cyberpank00/PLCJS_ETH_MODULE_12DQ_D4MG_STM32F407VGT6/DOC/SCM_12DQ.pdf

A A

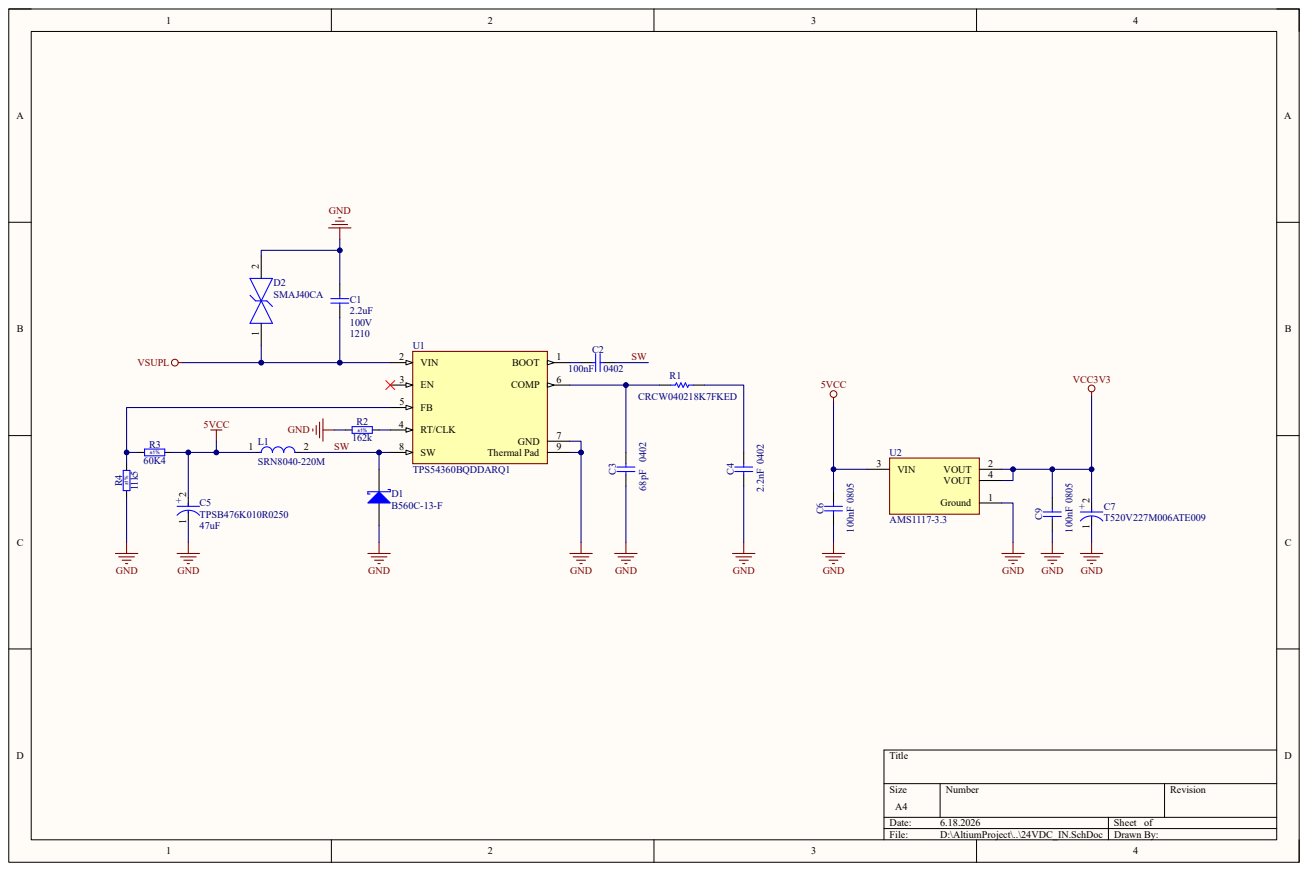
[picture p2: page 1]

11

22

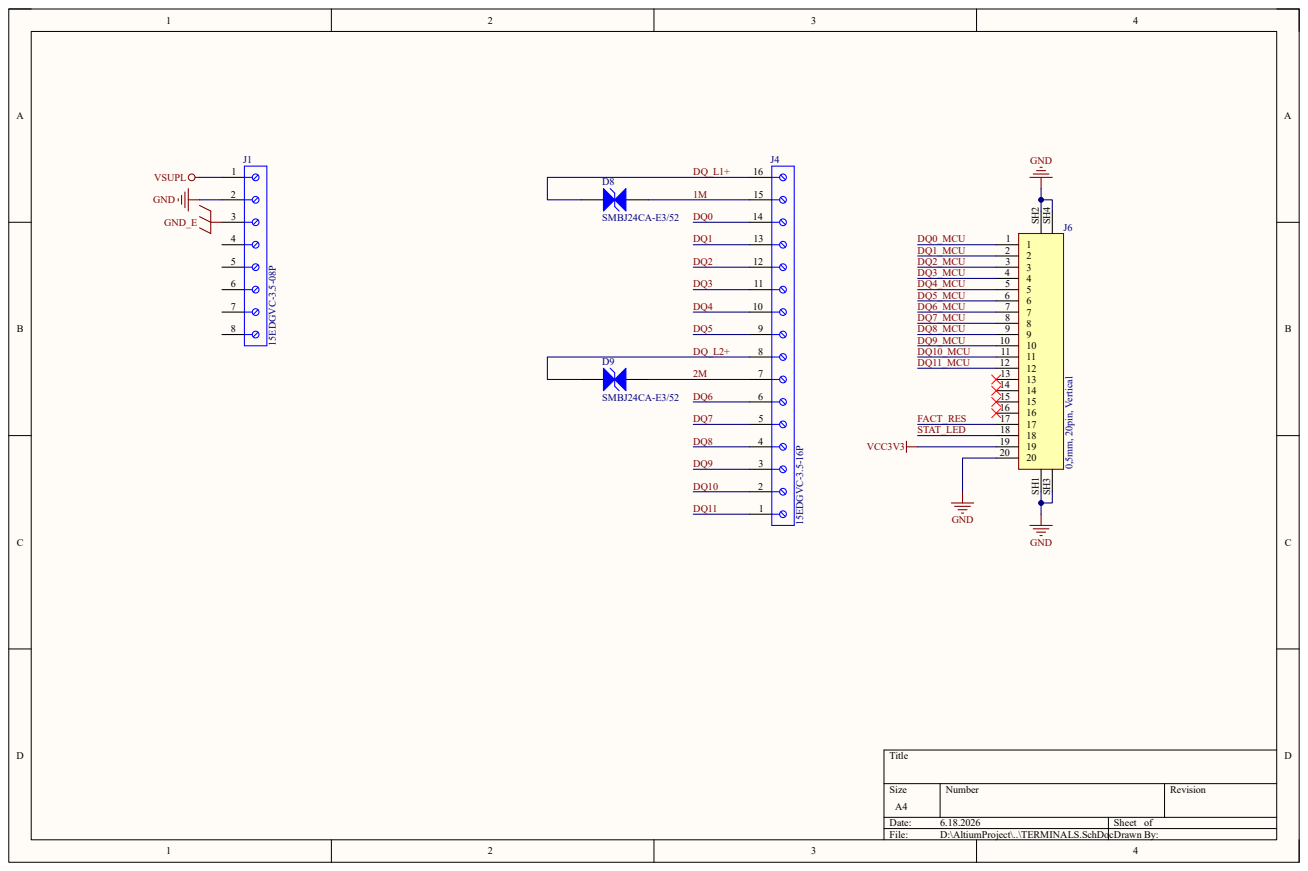
[picture p3: page 2]
Title; Size; Number; Revision; Date:; Sheet of; File:; D:\AltiumProject\..\TERMINALS.SchDocDrawn By:; VSUPL; GND; VCC3V3; 15EDGVC⁻³.5⁻08P; SH¹ SH³ SH² SH⁴; J60,5mm, 20pin, Vertical; 15EDGVC⁻³.5⁻16P; DQ0_MCU DQ1_MCU DQ2_MCU DQ3_MCU DQ4_MCU DQ5_MCU DQ6_MCU DQ7_MCU DQ8_MCU DQ9_MCU DQ10_MCU DQ11_MCU; STAT_LED; FACT_RES; GND_E; SMBJ24CA-E3/52

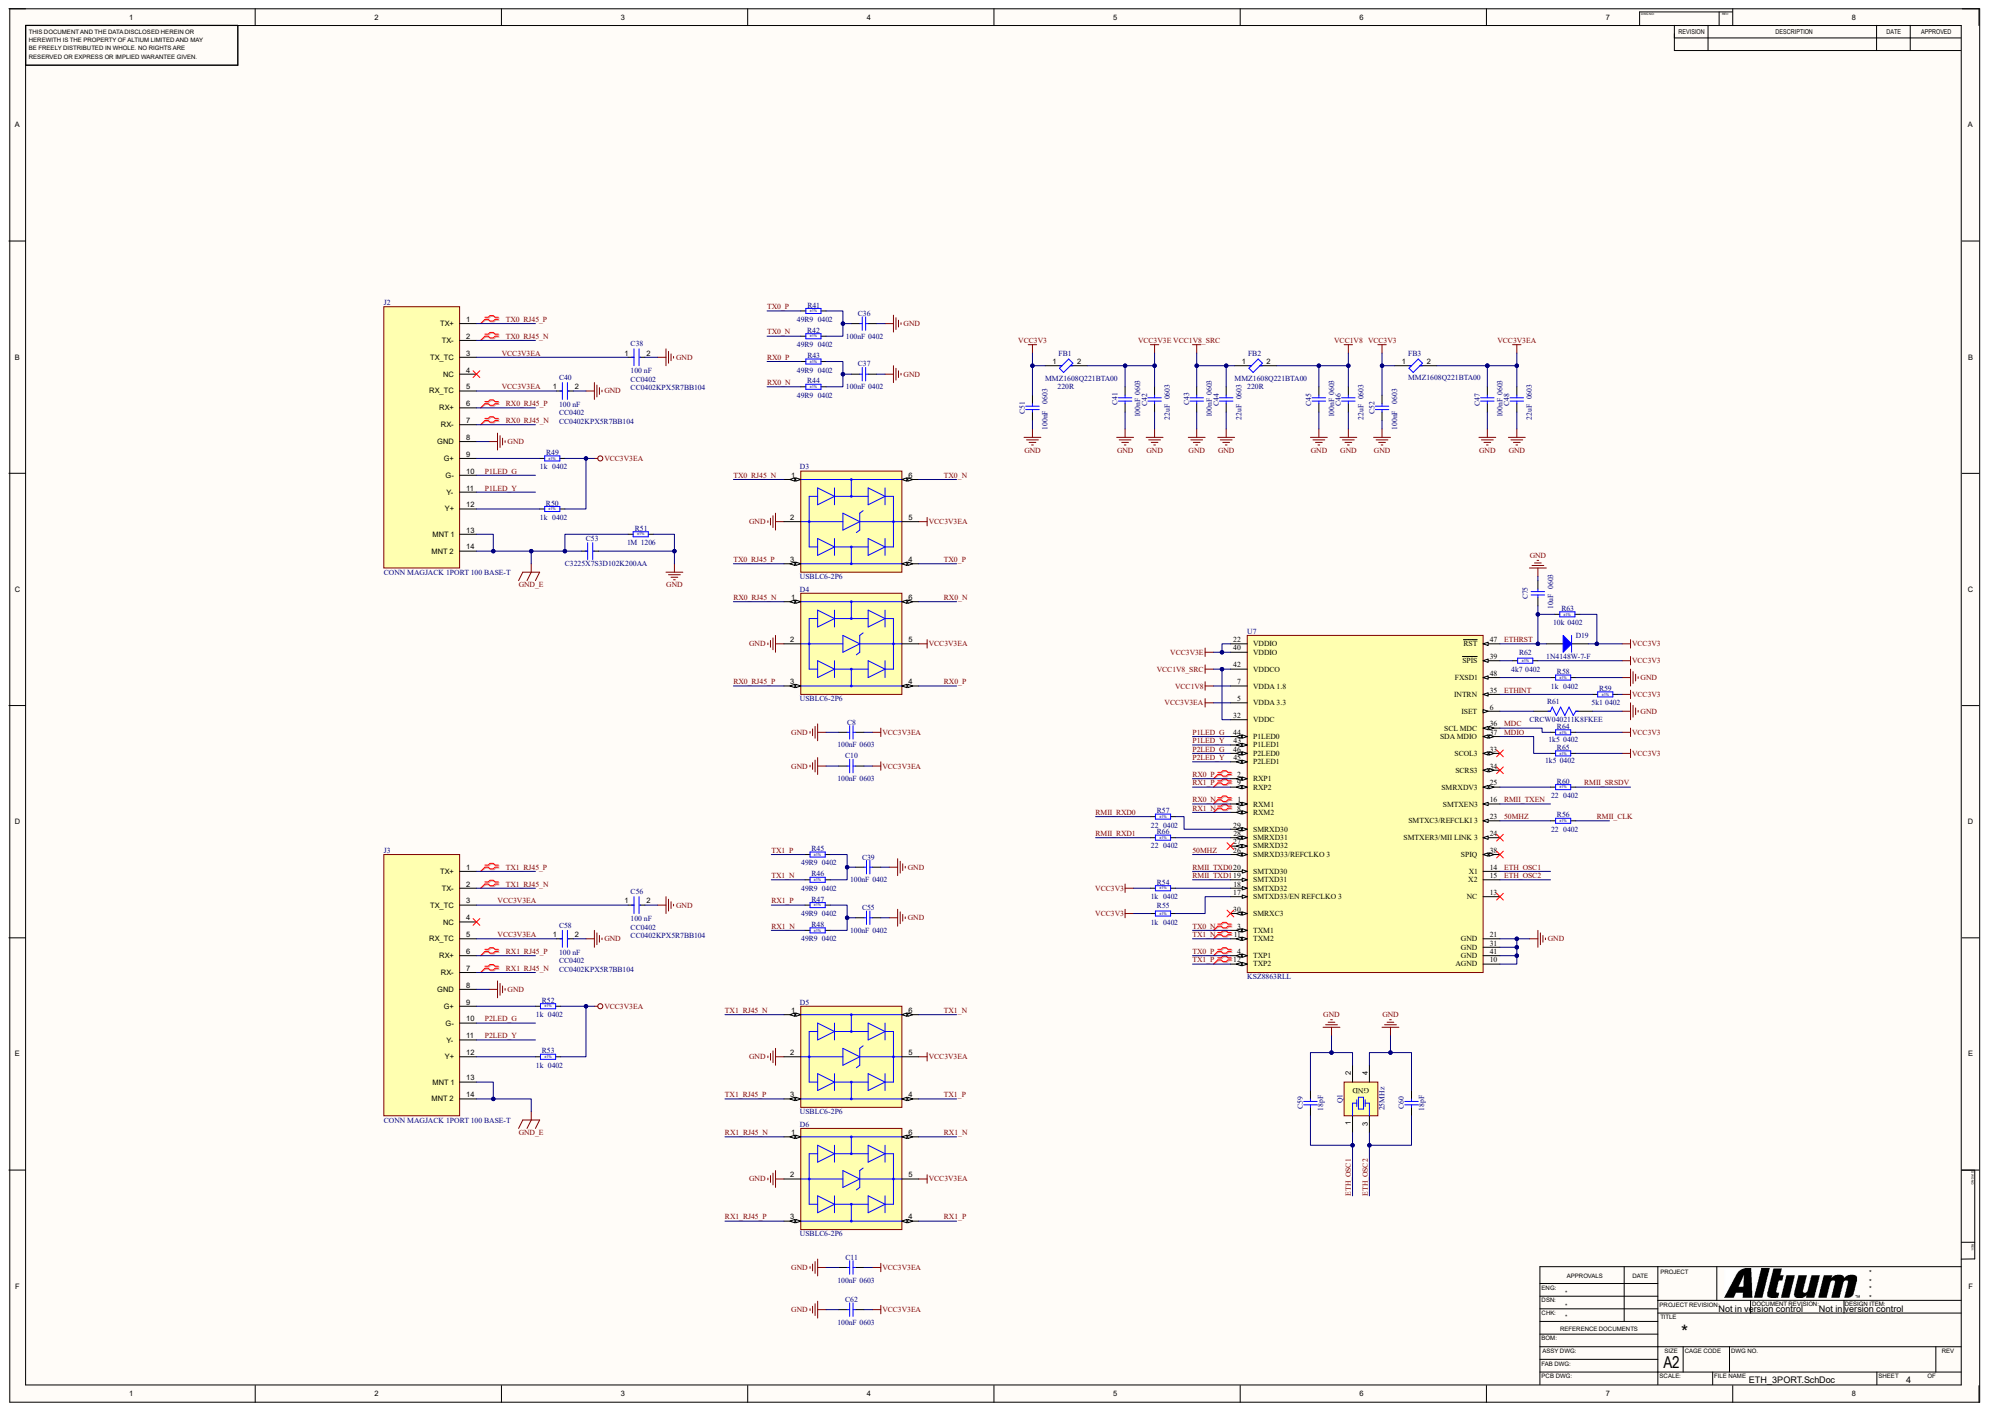
[picture p4: page 3]

7 | DWG NO: | REV: | 8

THIS DOCUMENT AND THE DATA DISCLOSED HEREIN OR HEREWITH IS THE PROPERTY OF ALTIUM LIMITED AND MAY BE FREELY DISTRIBUTED IN WHOLE. NO RIGHTS ARE RESERVED OR EXPRESS OR IMPLIED WARANTEE GIVEN. | R41 VCC3V3 VCC3V3E | REVISION | DESCRIPTION | DATE | APPROVED

ENG:
DSN:

PROJECT REVISION: | DOCUMENT REVISION: Not in version control | DESIGN ITEM: Not in version control

PCB DWG: | SCALE: | FILE NAME ETH_3PORT.SchDoc | SHEET 4 OF

## GND

1 2

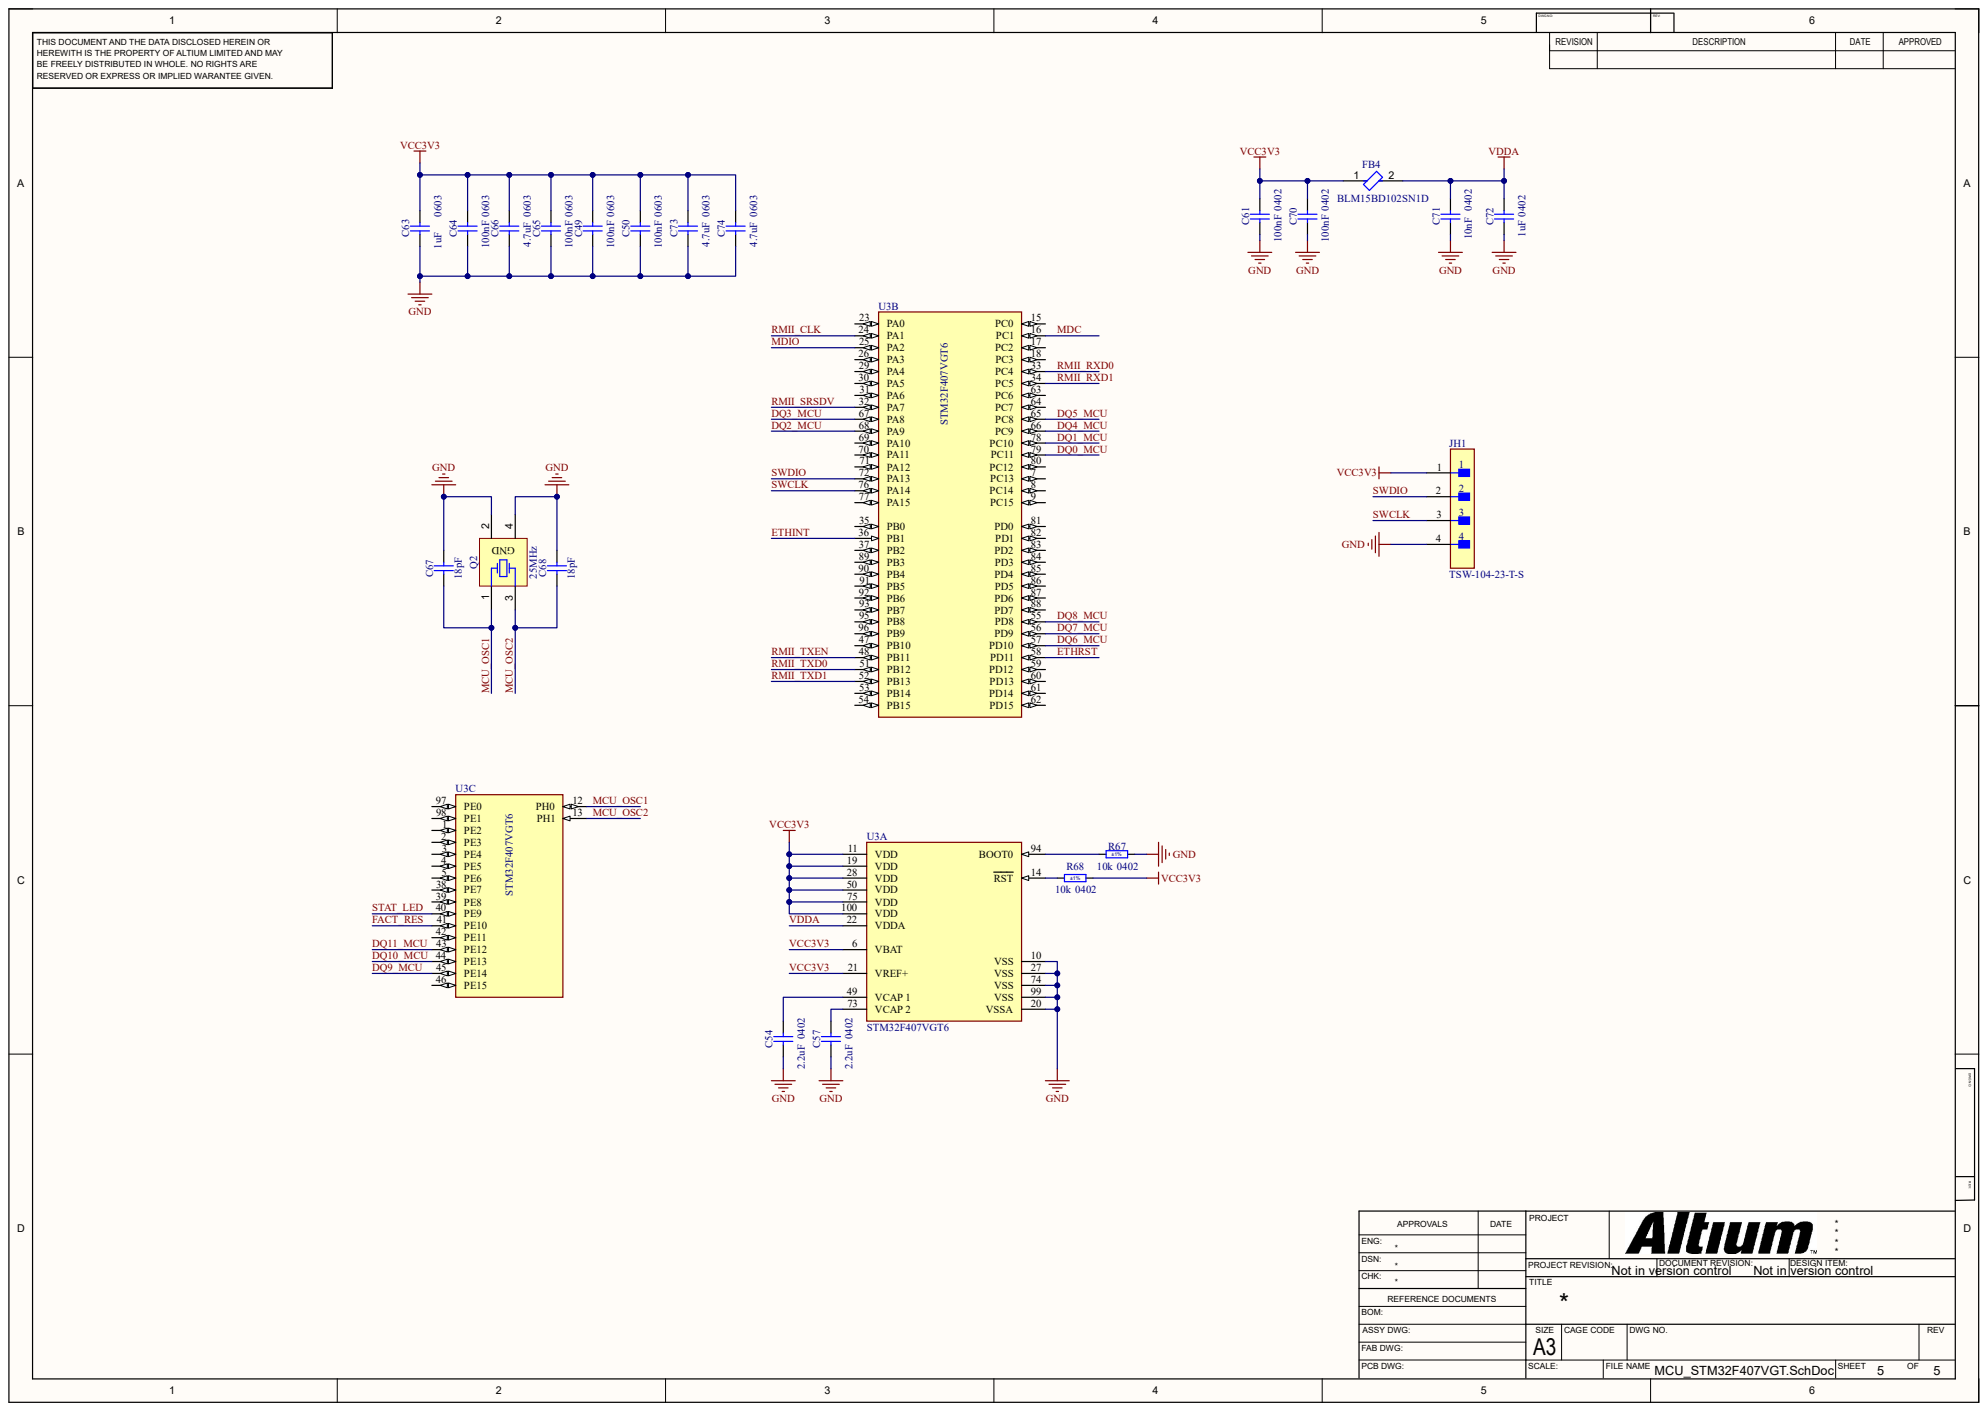
[picture p5: page 4]

APPROVALS | DATE | PROJECT | * *

ENG: *

DSN: *

PROJECT REVISION: | DOCUMENT REVISION: Not in version control | DESIGN ITEM: Not in version control

CHK: *

MCU_STM32F407VGT.SchDoc | 5

1M | 50V ⁰⁶⁰³ C¹² | 1uF
1M | 50V ⁰⁶⁰³ C¹³ | 1uF

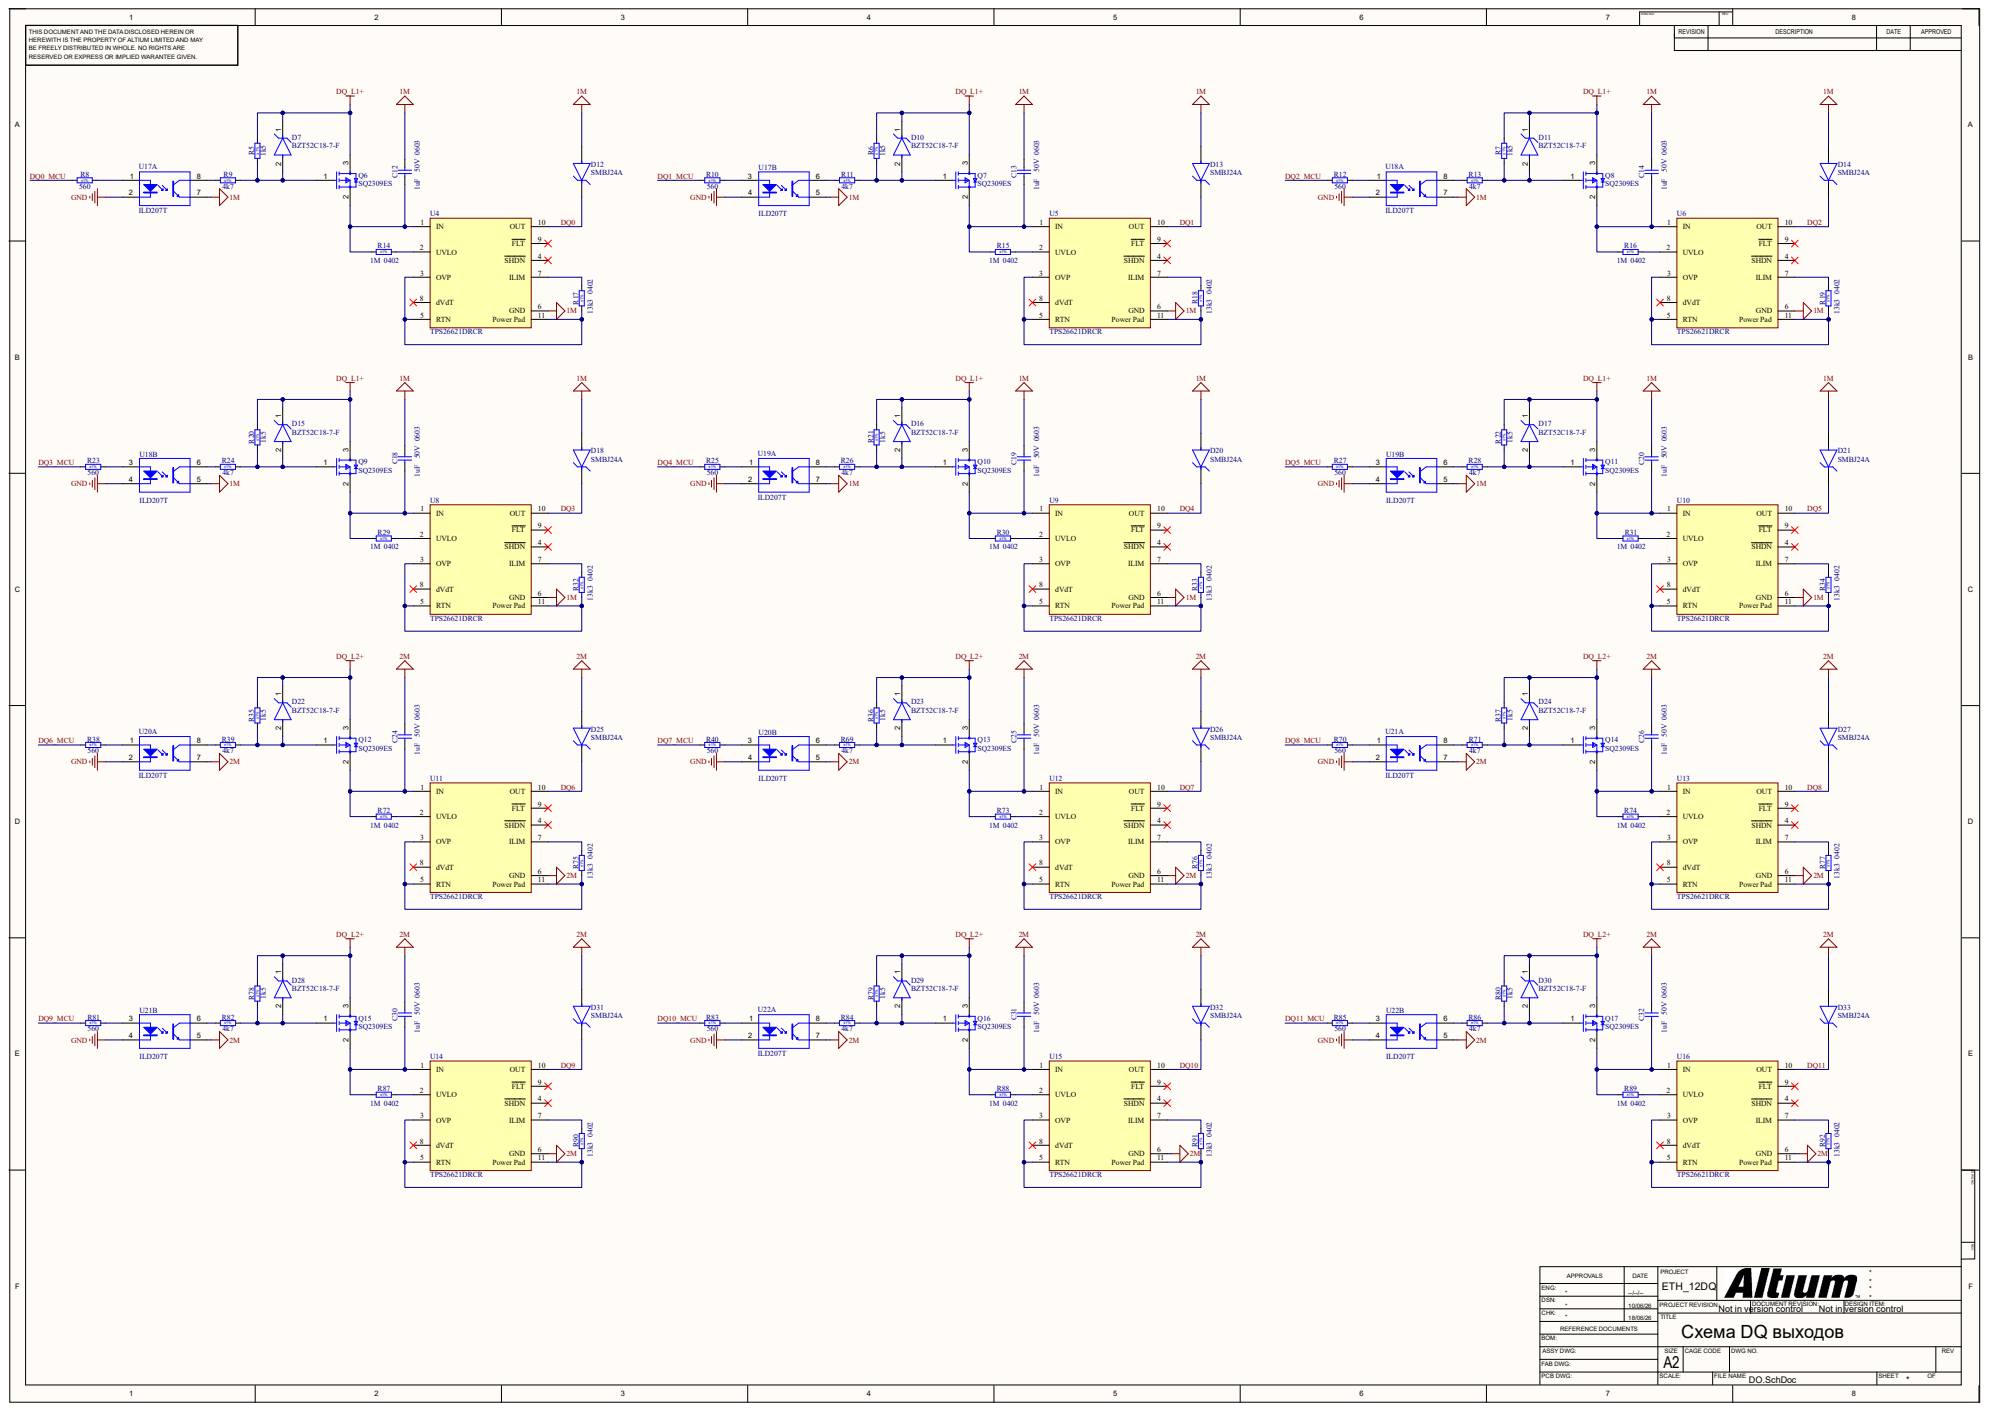
[picture p6: page 5]

APPROVALS | DATE | PROJECT ETH_12DQ | * * *

ENG: | --/--/--
DSN: | 10/06/26
CHK: | 18/06/26 | TITLE Схема DQ выходов

PROJECT REVISION: | DOCUMENT REVISION: Not in version control | DESIGN ITEM: Not in version control

DO.SchDoc | *
