cyberpank00/PLCJS_ETH_MODULE_12DQ_D4MG_STM32F407VGT6/(commit log)

2026-06-16 Port firmware from 12 discrete inputs (12DI) to 12 discrete outputs (12DQ)
    - Replace di_module (debounced inputs) with dq_module (12 push-pull
    outputs, direct/active-high polarity, DQ_ACTIVE_HIGH macro).
    - Per-output communication-loss handling: HOLD/ZERO/SAFE modes with a
    per-output x100 ms timeout, latched into safe state until the next
    explicit command (no auto-restore). Evaluated from the housekeeping loop.
    - Modbus map moved to a dedicated holding-register window 50..98 (no
    overlap with other module types): HR50 group mask, HR51..62 values,
    HR63..74 modes, HR75..86 safe values, HR87..98 timeouts. IR0..11 echo
    output state, IR124 output mask, IR125 module ID = 0x12D0 (12x DO)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
    [PLCJS_ETH_MODULE_12DQ_D4MG_STM32F407VGT6.ioc, app.c, dq_module.c, dq_module.h, main.h, modbus_app.c]
2026-06-18 Repin 12-DQ/FACT_RES/STAT_LED per updated .ioc; update GPIO init, docs, schematic
2026-07-29 Derive app MAC from STM32 96-bit UID (net_id) instead of hardcoded value
    Adds the net_id module (identical to the bootloader's) so the application
    computes a stable, locally-administered MAC from the chip UID. This makes the
    application and bootloader present the same per-device MAC, giving a consistent
    DHCP lease across bootloader<->app transitions. Replaces the hardcoded
    02:01:23:45:67:89 in ethernetif.c low_level_init.
    Generated with [Devin](https://devin.ai)
2026-07-29 Rewrite README around device operation and Modbus map
    Prioritize user-facing setup, technical parameters, output behavior, and the verified register table while moving development details to the end.
    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
2026-07-30 Add random-pattern EMC/back-EMF stress test for 12DO outputs
    Tools/dq_random_stress_test.mjs drives the 12 outputs with random 12-bit
    patterns via the group register (HR50) at a configurable rate (default 5 Hz)
    for a configurable duration (default 24 h). Each cycle verifies the echoed
    output mask (IR124) and watches uptime to detect faults: stuck/flipped
    channels from inductive back-EMF (per-channel mismatch counters), Modbus
    timeouts/link drops (auto-reconnect), and MCU resets/brown-outs from EMC.
    Prints periodic progress, supports graceful stop with a partial report, and
    de-energizes the outputs on exit. Self-contained on node:net (no deps).
    Co-Au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
2026-07-31 Modbus TCP: newest-wins session handling; bump fw 1.1->1.2
    The single-client Modbus server blocked in a per-connection loop, so a new
    connection could not be accepted while one was active. After an ungraceful
    drop (cable pull / switch reboot) the stale half-open connection kept the only
    slot, and a reconnect storm piled up in the backlog - reproduced as a ~7 min
    control outage in a 24 h stress test.
    Rework the server as a single non-blocking loop: the listener is polled every
    iteration, the newest incoming connection preempts the current client
    (newest-wins), older queued connections are drained/closed, and the client is
    dropped immediately on link-down. Bench-verified: preemption in <100 m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
2026-07-31 app: apply network settings live, no reboot needed to change IP/DHCP
    Re-apply network config to the live netif right after a settings save:
    apply_network_config() is now idempotent and runs via tcpip_callback() for
    LwIP thread-safety, so an IP/DHCP change takes effect immediately without a
    reboot. Mirrors the 12DI change.
    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
    [app.c]
2026-08-03 docs+tool: default IPs to 192.168.1.x; add relay stress-test script (.11/.10)
2026-08-03 Add PDP discovery protocol + AutoIP link-local factory addressing
    Port the discovery/link-local feature from 12DI (BOOTLOADER repo commit
    context; 12DI commit d1179ca) to this variant:
    - New UDP discovery responder ("PDP", port 20556, broadcast) — IDENTIFY,
    SET_NET (live), SET_NAME, FLASH_LED, REBOOT, FACTORY, addressed by MAC so a
    module can be found/assigned regardless of its IP/subnet.
    - Factory/unconfigured network state is now AutoIP link-local (169.254.0.0/16),
    derived deterministically from the MAC (169.254.mac[4].mac[5]); net_mode gains
    a third value (0=static, 1=DHCP, 2=link-local, default).
    - settings.use_dhcp reused as net_mode (no on-flash layout change / version
    bump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
    [app.c, led_module.c, led_module.h, modbus_app.c, settings.h]
2026-08-05 docs: factory addressing is now link-local + discovery (PDP)
    Update the README to match the firmware: the factory/unconfigured network mode
    is AutoIP link-local (169.254.mac[4].mac[5], USE_DHCP=2), the device is found
    by MAC via the PDP discovery protocol (UDP broadcast 20556, inbound firewall
    rule required), reg 116 now takes 0=static/1=DHCP/2=link-local and applies live
    on save, and the label MAC/IP can be precomputed with the bootloader repo's
    tools/device_id.mjs.
    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
2026-08-05 discovery: fixed 16-byte name field on the wire (uniform 38-byte IDENTIFY)
    The IDENTIFY response emitted `22 + SETTINGS_NAME_LEN` bytes, which is 38 on
    12DI/4RTD (name[16]) but only 30 on 12DO (name[8]) — and every client parses a
    fixed 38-byte payload, so a running 12DO application was rejected/partially
    parsed by the discovery tools. Always emit a fixed 16-byte, zero-padded name
    field (copying at most SETTINGS_NAME_LEN bytes from storage) so all variants and
    the bootloader produce an identical 38-byte IDENTIFY payload.
    Verified on 12DO hardware: after the fix the app's IDENTIFY parses fully
    (product 0x504C1202, link-local, name), and SET_NET/FLASH_LED/Modbus all work.
    Generated with [D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
2026-08-05 settings: grow device name 8->16 bytes (unify 15-char limit), bump v2
    12DO stored the discovery device name in the 8-byte reserved field, capping it
    at 7 chars while 12DI/4RTD allow 15. Grow name[8]->name[16] so the SET_NAME
    limit (15 chars) is identical across all variants. The settings struct size
    changes, so SETTINGS_VERSION is bumped 1->2; v1 images are rejected on load and
    fall back to factory defaults (link-local) — acceptable, as 12DO is being
    reflashed to the link-local/discovery firmware anyway.
    Verified on 12DO hardware: SET_NAME "12DO-NAME-15CHR" (15 chars) stored and
    returned in full by IDENTIFY.
    Generated with [Devin](https://devin.ai)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
2026-08-05 Minimize KSZ8863 resets: reset only on cold boot, add recovery service
    The module is a pass-through switch, so the KSZ8863 must keep forwarding between its external ports across MCU restarts. ETHRST now initializes high, the hardware reset runs only on power-on/brown-out, Error_Handler releases the reset line, SMI health monitoring performs a rate-limited automatic recovery, and Modbus register 118 accepts 0x8863 for an operator-forced switch reset.
    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
    [PLCJS_ETH_MODULE_12DQ_D4MG_STM32F407VGT6.ioc, app.c, main.c, modbus_app.c, modbus_app.h]
2026-08-06 nanoMODBUS: harden server against malformed FC15/FC16 frames; bump fw to 1.7
    The Modbus request byte-count (coils_bytes / registers_bytes) is an
    attacker-controlled wire value (0..255) that was used to drive recv()
    and the copy loop BEFORE any validation. A crafted FC15/FC16 frame could
    therefore overflow both the shared msg.buf[260] and the local
    registers[123] / coils[250] arrays before the quantity/byte-count checks
    ran (stack-based buffer overflow, CVE-2026-29972 class; potential RCE/DoS
    on MPU-less Cortex-M targets).
    Fixes:
    - recv_msg_header (TCP): tighten the MBAP length check from '> 255' to
    the valid range '< 2 || > 253' (unit_id + max 252-byte PDU), so a
    crafted frame can never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
2026-08-09 docs: expand AGENTS.md from build notes into an orientation map
    AGENTS.md only covered the build. Add the module map, the single sources of
    truth (identity in fw_header.h, register map in modbus_app.h), the mandatory
    version-bump policy, threading and boot-order constraints, the linker/memory
    contract with the bootloader, the hardware test scripts, and the multi-repo
    notes -- most importantly that Application/ subsystems are copy-pasted
    between variants rather than shared, so a fix here is not a fix elsewhere.
    Also records that the sector comment in settings.c is stale (it says sector
    11 / 0x080E0000; the code uses sector 10 / 0x080C0000, and sector 11 is
    bootloader staging).
    Generated wit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
2026-08-09 tooling: track .clangd and a workspace file so both dev machines match
    12DQ was the odd one out: .clangd was listed in .gitignore and absent from
    the tree, so clangd indexing had to be set up by hand on every machine while
    12DI/4RTD/bootloader/ModbusTool all ship theirs. Take the 4RTD copy verbatim
    (CompilationDatabase build/Debug, arm-none-eabi-gcc as the indexing driver)
    so all three firmwares are identical.
    Also add the multi-root workspace (this repo + the bootloader, which owns the
    fw_header/flash-map contracts) and ignore .cache/, clangd's index directory.
    The workspace deliberately does NOT set --compile-commands-dir: in a
    multi-root workspace ${workspaceFolder} resolves to the firs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
2026-09-09 Modbus TCP: serve up to 4 clients concurrently; fw 1.8
    modbus_tcp_server.c now keeps 4 client slots, each with its own nanoMODBUS
    context and buffers, polled round-robin from the single server task with a
    2 ms first-byte timeout so idle connections never delay a busy one. A new
    connection takes a free slot; only when all four are busy does it evict the
    longest-silent client (newest-wins). Silent clients still drop after 30 s,
    TCP keep-alive and link-down handling unchanged. lwipopts: MEMP_NUM_NETCONN /
    NETBUF / TCP_PCB raised to 8.
    Verified on 12DI hardware: 4 pollers x 15 s, ~20k requests each, 0 errors,
    p50 0.7 ms / max 16 ms; a 5th connection evicts exactly the silent slot.
    Generated wi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
2026-09-10 Небольшой тест переключения DO0 по DI0
2026-09-30 Modbus TCP / link / LED: port the 4RTD fw 2.7-2.10 fixes; fw 1.9
    Ported from 4RTD (identical shared code):
    - client slots are closed with tcp_abort (RST) under LOCK_TCPIP_CORE(), not FIN: a FIN to a vanished peer left the pcb in FIN_WAIT_1 for minutes and ~5 cable pulls exhausted the pcb pool, after which LwIP silently dropped every SYN. MEMP_NUM_TCP_PCB 8 -> 12.
    - the server drops clients on the debounced netif link state (g_eth_link_stable), not on the instantaneous KSZ8863 flag that blips for ~10 s after a re-plug.
    - nmbs_server_poll() returns NONE for 'nothing arrived' too; a request now counts only when a response was produced. Before, idle-drop never fired, POLLING lit for silent clien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
    [app.c, led_module.c, led_module.h]
2026-10-29 PDP SET_NET: ARP address-in-use probe before applying; settings-save counter/result in IR129/IR130; fw 1.10
    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
