cyberpank00/PLCJS_ETH_MODULE_12DQ_D4MG_STM32F407VGT6/(notices)

Notices in the files:
Core/Inc/main.h:
Copyright (c) 2026 STMicroelectronics.
All rights reserved.
This software is licensed under terms that can be found in the LICENSE file
